samuelkadolph/z-rowenta/(commit log)

2017-11-01 Change ON to POWER_ON, OFF to POWER_OFF, and handled changing speed while off
2017-11-04 Change logging format a bit and delay changing speed for 2.5s after the fan turns on
2017-11-04 Work on the device handler
2017-11-13 Shrink complete fan image
2017-11-23 Use 255 instead of 1 for POWER_ON
